julio7745/PETA/Programa de interface gráfica/Fotos base/2.png

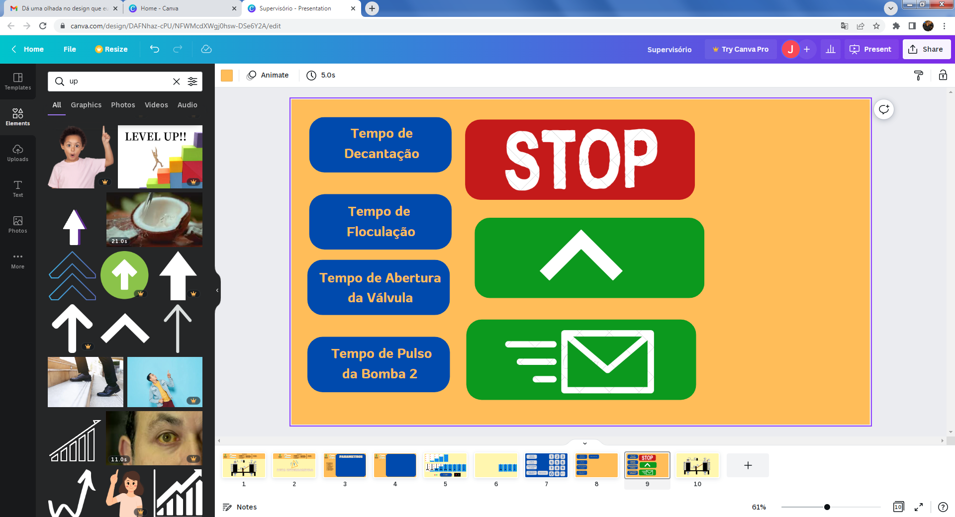
Programa de interface gráfica/Fotos base/2.png
