julio7745/PETA/Ferramentas Planejamento/Planilha Projeto Interdisciplinar (1).pdf

# Divisão de Funções

Componentes | Líderes responsáveis
Atuadores | Emanuelle Araújo
Sensores | Lorrana Aparecida
Controladores | Sthefane Gonçalves
Placas de circuitos | Júlio César

# LÍDER DE EQUIPE: Lucas Barbosa

Coordenador de montagem: | Coordenador de automação:
Marisa Camargos | Júlio César
Estrutura | Lucas Barbosa | Controlador | Marisa Camargos
| Emanuelle Araújo | | Sthefane Gonçalves
| Sthefane Gonçalves | Supervisor | Yasmin Mariane
Instrumentação | Lorrana Aparecida | | Emanuelle Araújo
| Marisa Camargos | | --
| Júlio César | Eletrônica | Lucas Barbosa
| Yasmin Mariane | | Júlio César
| -- | | Lorrana Aparecida

# Lista de materiais e previsão orçamentária

Tipo de material | Quantidade | Aquisição | Doação | Preço em reais

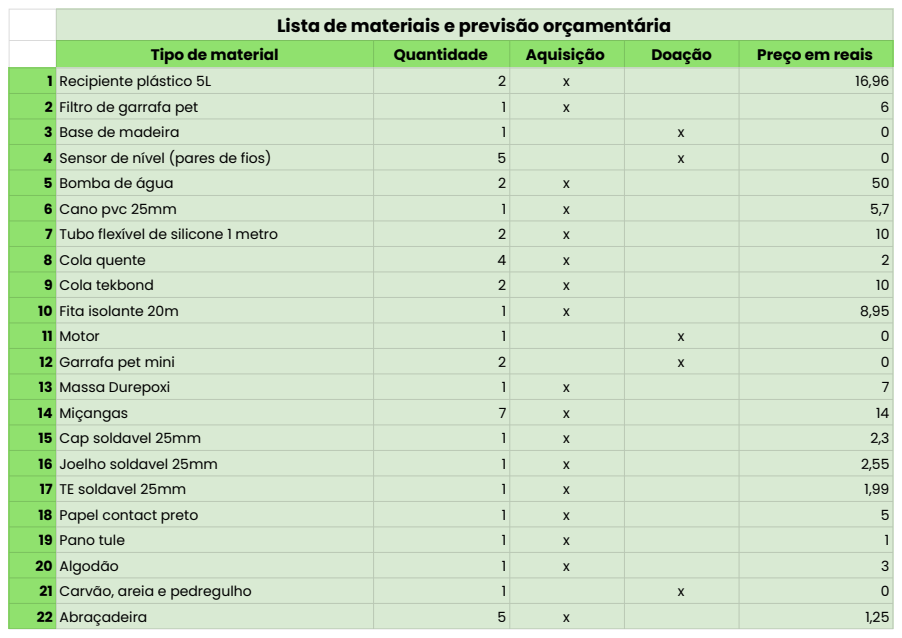
[picture p2: page 3]
Recipiente plástico 5L; Filtro de garrafa pet; Base de madeira; Sensor de nível (pares de fios); Bomba de água; Cano pvc 25mm; Tubo flexível de silicone 1 metro; Cola quente; Cola tekbond; Fita isolante 20m; Motor; Garrafa pet mini; Massa Durepoxi; Miçangas; Cap soldavel 25mm; Joelho soldavel 25mm; TE soldavel 25mm; Papel contact preto; Pano tule; Algodão; Carvão, areia e pedregulho; Abraçadeira

23 Servo motor | | 1 | | x | 0
24 Mixer | | 1 | | x | 0
25 Arame | | 1 | | x | 0
26 Cola silicone | | 1 | x | | 11
27 Placa de Circuito Impresso | | 1 | x | | 57,4
28 Cano pvc 50mm | | 1 | | x | 0
29 Componentes eletrônicos | | | x | | 51
30 Transporte do projeto | | 2 | x | | 20
31 Adesivo | | 1 | x | | 5,5
32 Componentes eletrônicos a parte | | | x | | 54,71
Total | 347,31

## CRONOGRAMA DE EXECUÇÃO DO PROJETO

TAREFAS

PRAZOS

MARÇO | ABRIL | MAIO | JUNHO | JULHO | AGOSTO | SETEMB | OUTUB

Definição do tema

Reunião com orientador
Confecção diagrama P&I

Estrutura no CAD

Fluxograma
Vídeo PITCH

Lista de materiais

Envio de documentos

Revisão e correção dos arquivos

Apresentação

Montagem da estrutura

Divisões do documento

Reunião entre os integrantes

Aquisição dos materiais
Materiais para parte elétrica Cronograma e atualizações

Correção de erros da estrutura

Desenvolvimento da parte elétrica

Testes
Aquisição da PCB

Tarefas realizadas
Tarefas a realizar

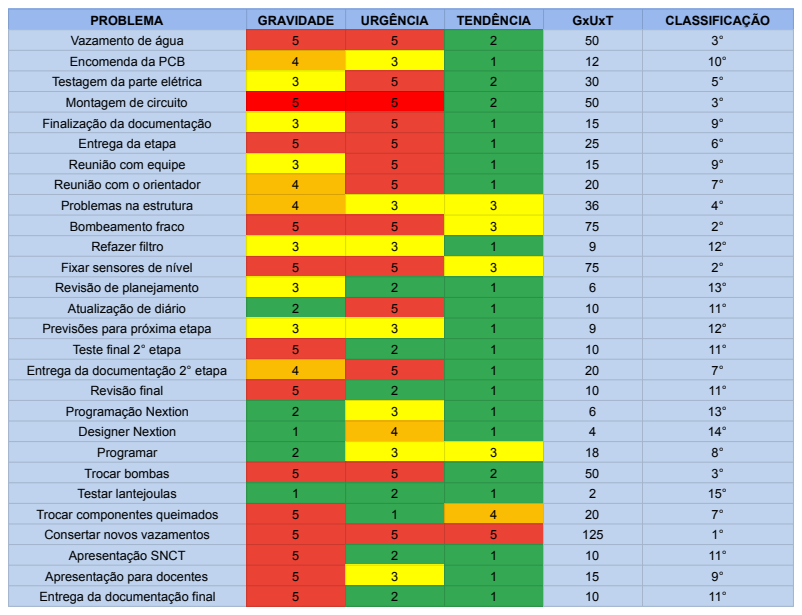
[picture p3: page 6]
PROBLEMA; GRAVIDADE; URGÊNCIA; TENDÊNCIA; GxUxT; CLASSIFICAÇÃO; Vazamento de água; Encomenda da PCB; Testagem da parte elétrica; Montagem de circuito; Finalização da documentação; Entrega da etapa; Reunião com equipe; Reunião com o orientador; Problemas na estrutura; Bombeamento fraco; Refazer filtro; Fixar sensores de nível; Revisão de planejamento; Atualização de diário; Previsões para próxima etapa; Teste final 2° etapa; Entrega da documentação 2° etapa; Revisão final; Programação Nextion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

## CHECK LIST

ATIVIDADES | NÃO | PARCIALMENTE | SIM
Reunião com o orientador . | | | X
Definição das fases do Projeto. | | | X
Reunião para dar início a 1º documentação do projeto | | | X
Divisão de tarefas para a primeira entrega. | | | X
Execução das tarefas relacionadas a 1º entrega | | | X
Envio do documento para o orientador fazer a correção | | | X
Montagem do documento para a entrega da 1ºEtapa | | | X
Entrega do 1º documento no AVA | | | X
Correção do documento eviado na 1º Etapa | | | X
Compra de matériais | X
Início ao processo de construção do protótipo | | | X
Apresentação da estrutura do projeto | | | X
Teste de verificação da estrutura | | | X
Adaptações no protótipo | | | X
Início a montagem do circuito | | | X
Reunião para dar início a 2º documentação do projeto | | | X
Divisão de tarefas para a segunda entrega. | | | X
Execução das tarefas relacionadas a segunda entrega. | | | X
Montagem do documento para a entrega da 2ºEtapa | | | X
Entrega do 2º documento no AVA | | | X
Correção do documento enviado na 2º Etapa | | | X
Execução de tarefas relacionadas a terceira entrega | | | X
Revisão dos documentos e outros | | | X
Checagem final do protótipo | | | X
Divisão das funções para a apresentação | | | X
Apresentação final na SNCT | | | X
Entrega final dos documentos no AVA | | | X
