julio7745/PETA/P_I/Diagrama P_I PETA.pdf

A | B | C | D | E | LEGENDA

A

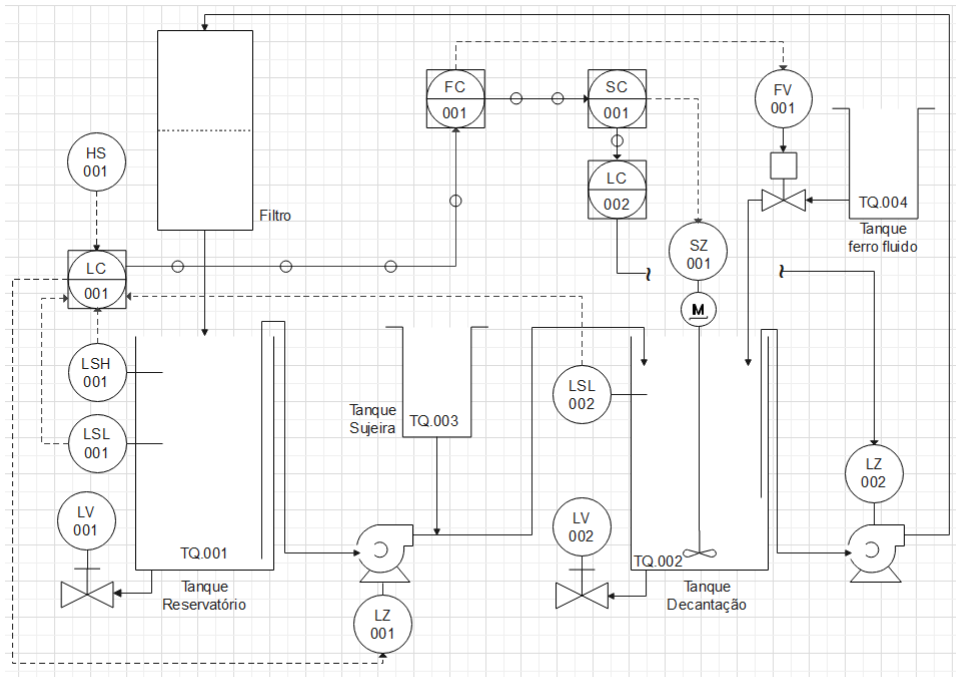
[picture p4: figure]

B

C

D

E

REV | DATA | DES | REV | AP
01 | 25.04.2022 | JCQC | LBO | LBO
02 | 16.06.2022 | JCQC | LBO | LBO
03 | 26.06.2022 | JCQC | MCB | LBO

## Protótipo de Estação de Tratamento de Água

Diagrama P&I PETA
