julio7745/PETA/Programa de interface gráfica/Fotos base/3.png

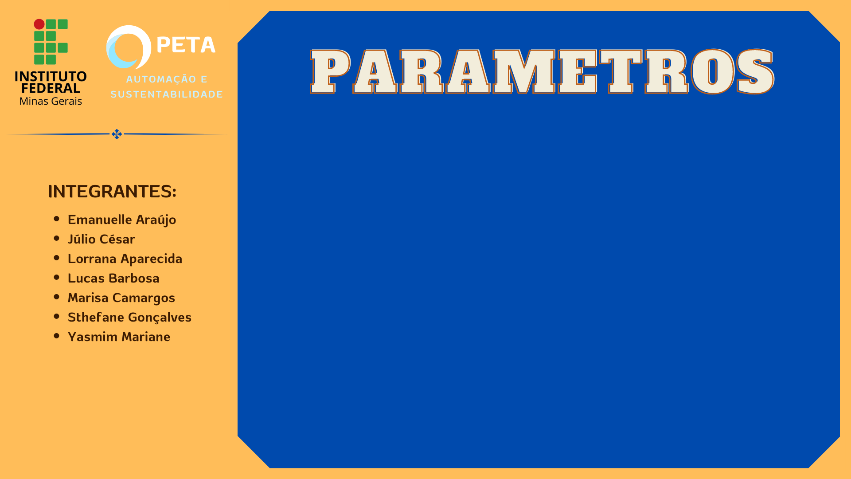
Programa de interface gráfica/Fotos base/3.png
