julio7745/PETA/Programa de interface gráfica/Fotos base/4.png

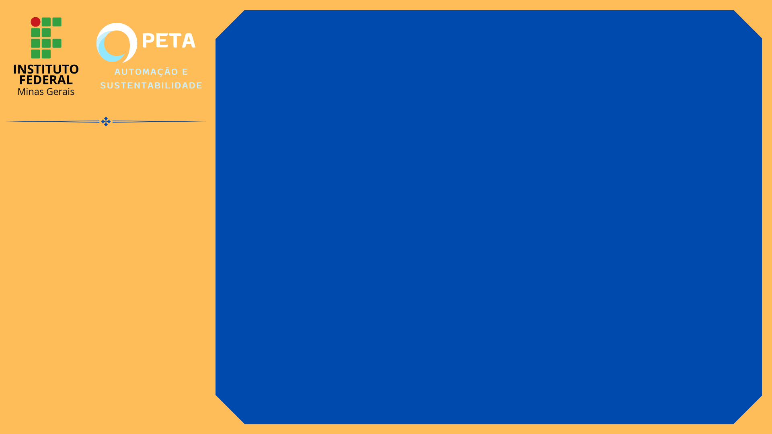
Programa de interface gráfica/Fotos base/4.png
