julio7745/PETA/Programa de interface gráfica/Fotos base/5.png

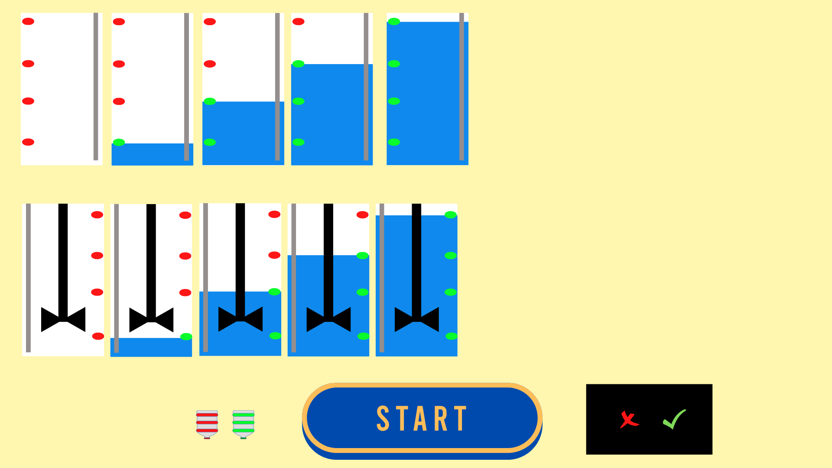
Programa de interface gráfica/Fotos base/5.png
