julio7745/PETA/Programa de interface gráfica/Fotos base/6.png

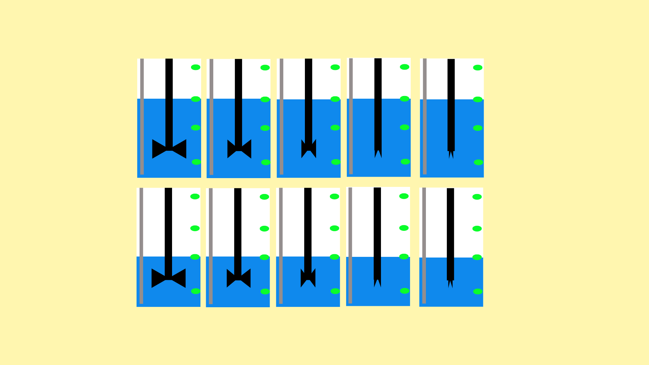
Programa de interface gráfica/Fotos base/6.png
