julio7745/PETA/Programa de interface gráfica/Fotos base/7.png

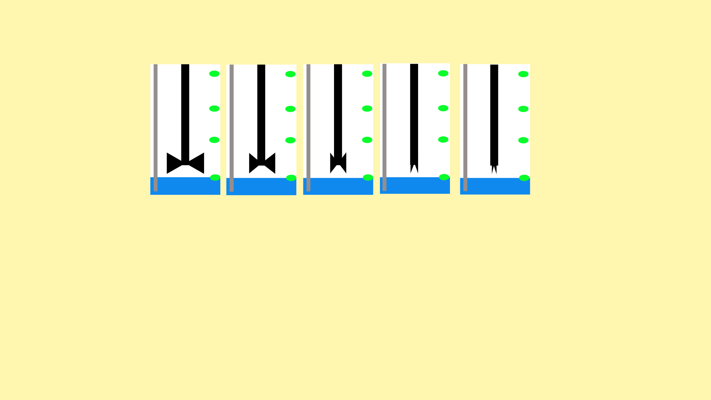
Programa de interface gráfica/Fotos base/7.png
