julio7745/PETA/Programa de interface gráfica/Fotos base/9.png

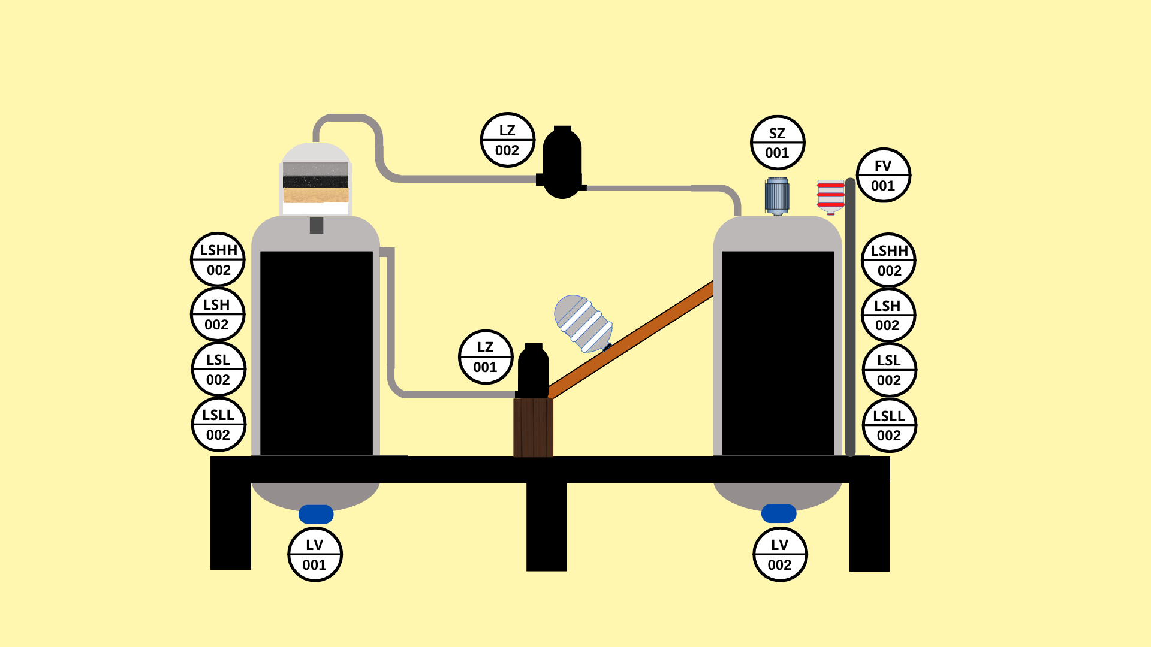
Programa de interface gráfica/Fotos base/9.png
