julio7745/PETA/Programa de interface gráfica/Fotos base/10.png

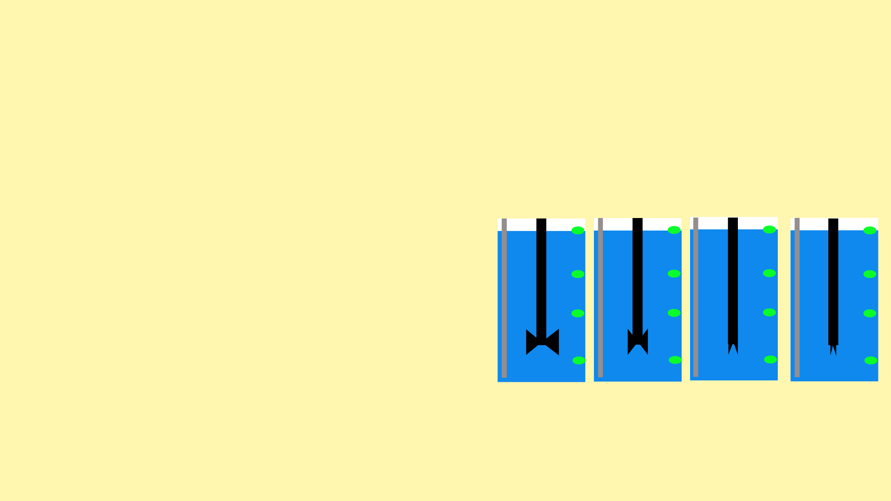
Programa de interface gráfica/Fotos base/10.png
