julio7745/PETA/Programa de interface gráfica/Fotos base/11.png

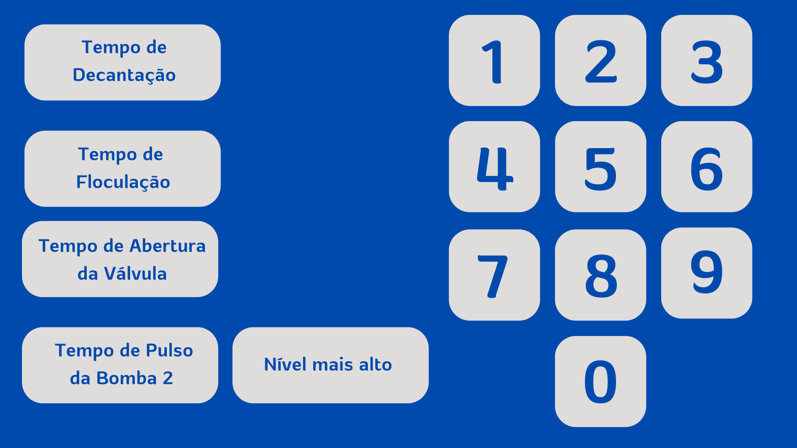
Programa de interface gráfica/Fotos base/11.png
