julio7745/PETA/Programa de interface gráfica/Fotos base/12.png

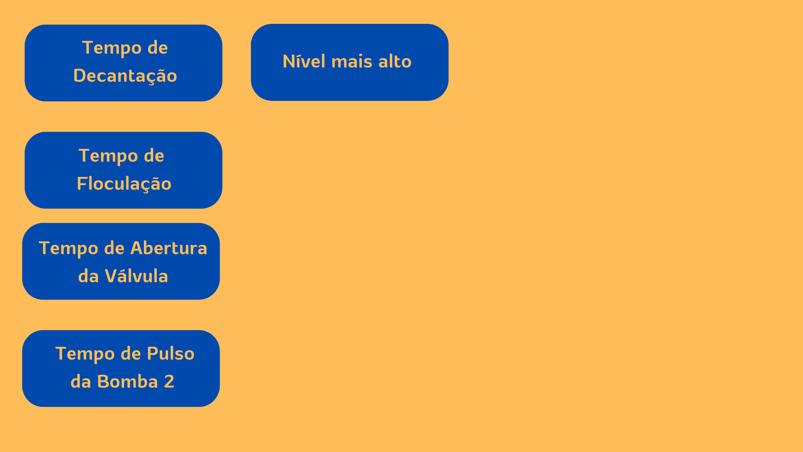
Programa de interface gráfica/Fotos base/12.png
