julio7745/PETA/Programa de interface gráfica/Fotos base/13.png

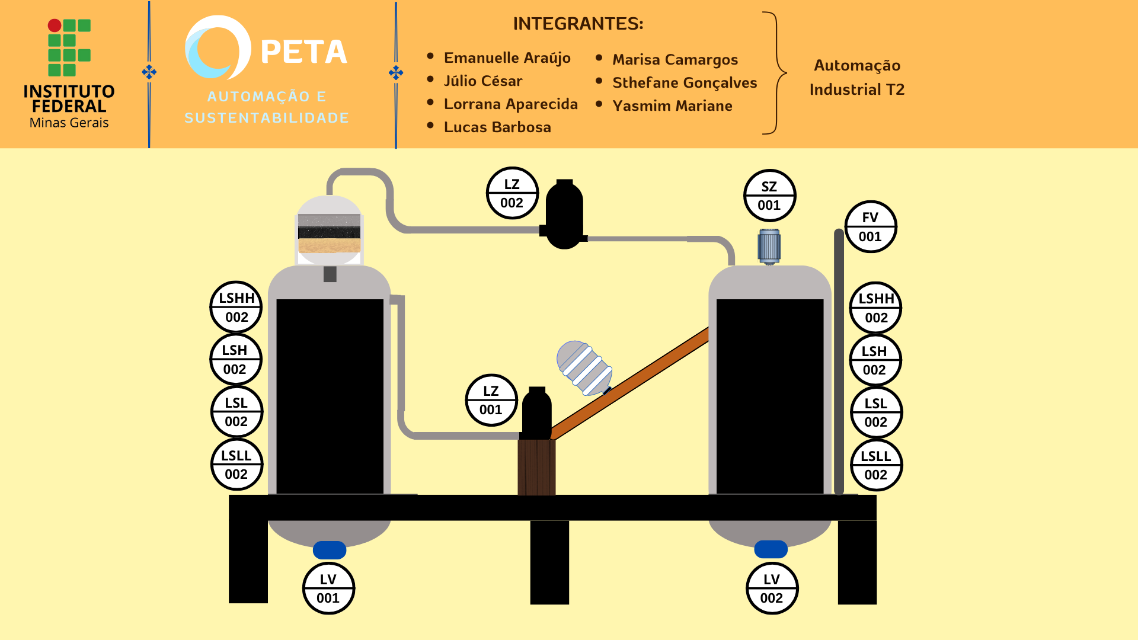
Programa de interface gráfica/Fotos base/13.png
