julio7745/PETA/Programa de interface gráfica/Fotos base/14.png

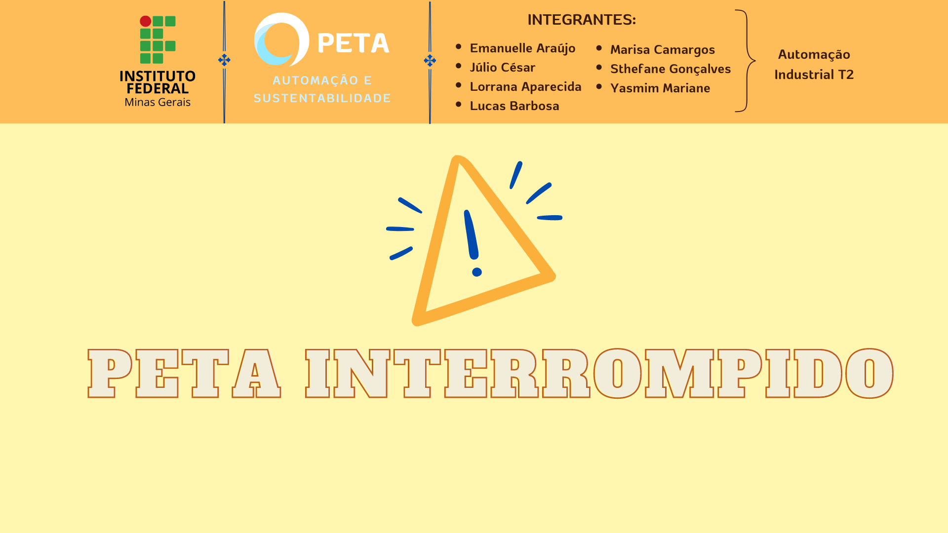
Programa de interface gráfica/Fotos base/14.png
