julio7745/PETA/Programa de interface gráfica/Fotos base/15.png

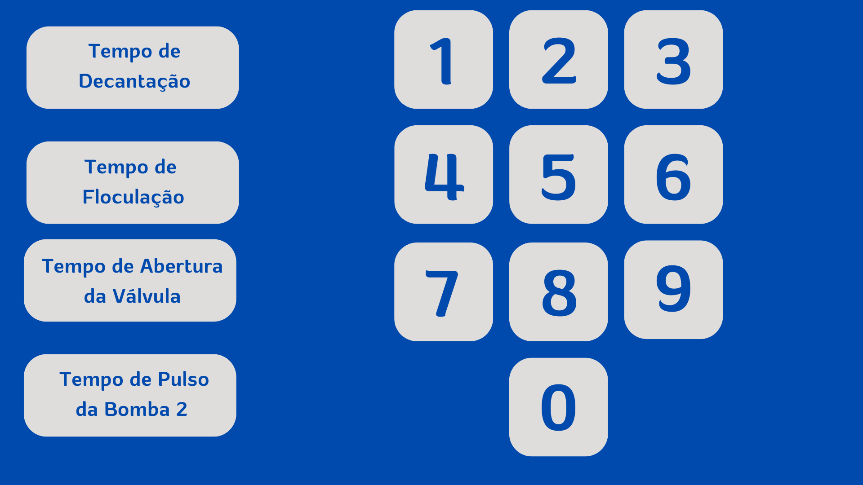
Programa de interface gráfica/Fotos base/15.png
