julio7745/PETA/Programa de interface gráfica/Fotos base/16.png

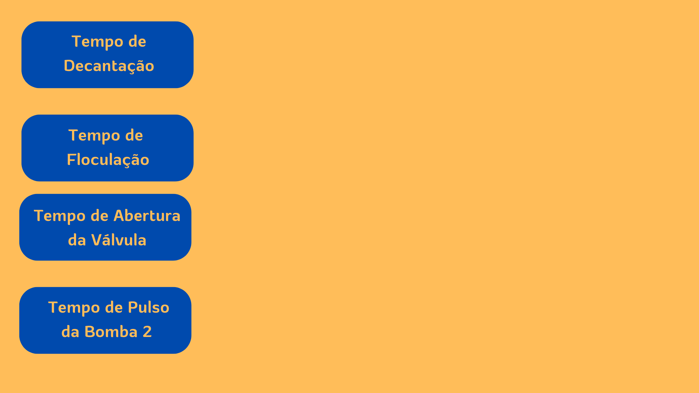
Programa de interface gráfica/Fotos base/16.png
