julio7745/PETA/Programa de interface gráfica/Fotos base/18.png

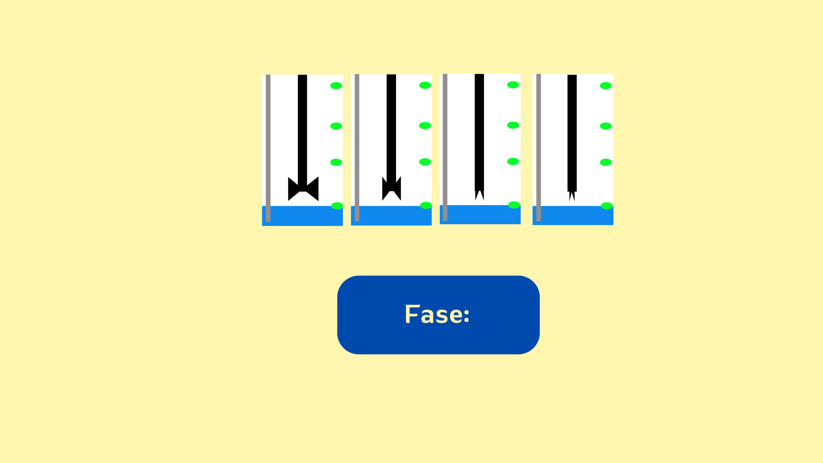
Programa de interface gráfica/Fotos base/18.png
