julio7745/PETA/Desenvolvimento PCB/PCB PETA prints.pdf

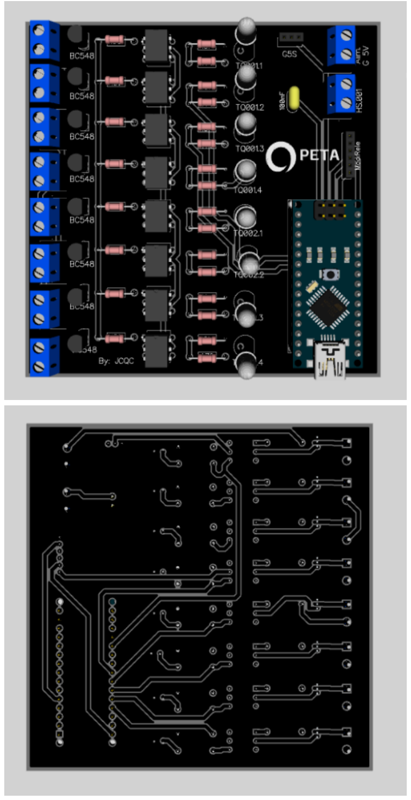
[picture p35: page 1]
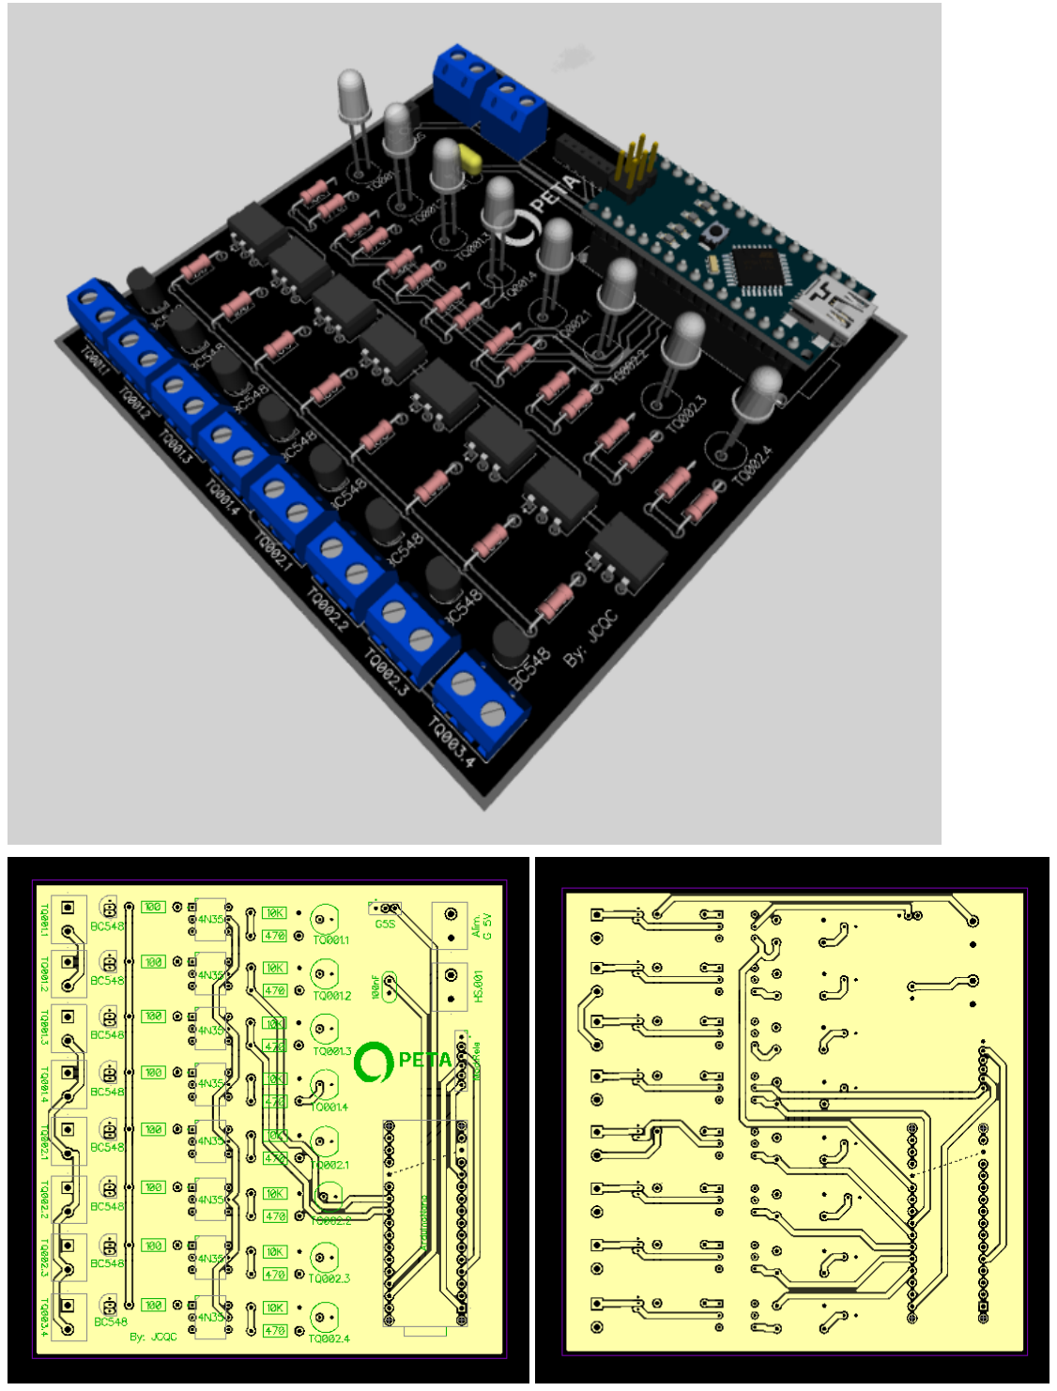
[picture p36: page 2]
