julio7745/PETA/Desenvolvimento PCB/PCB PETA orcamento.pdf

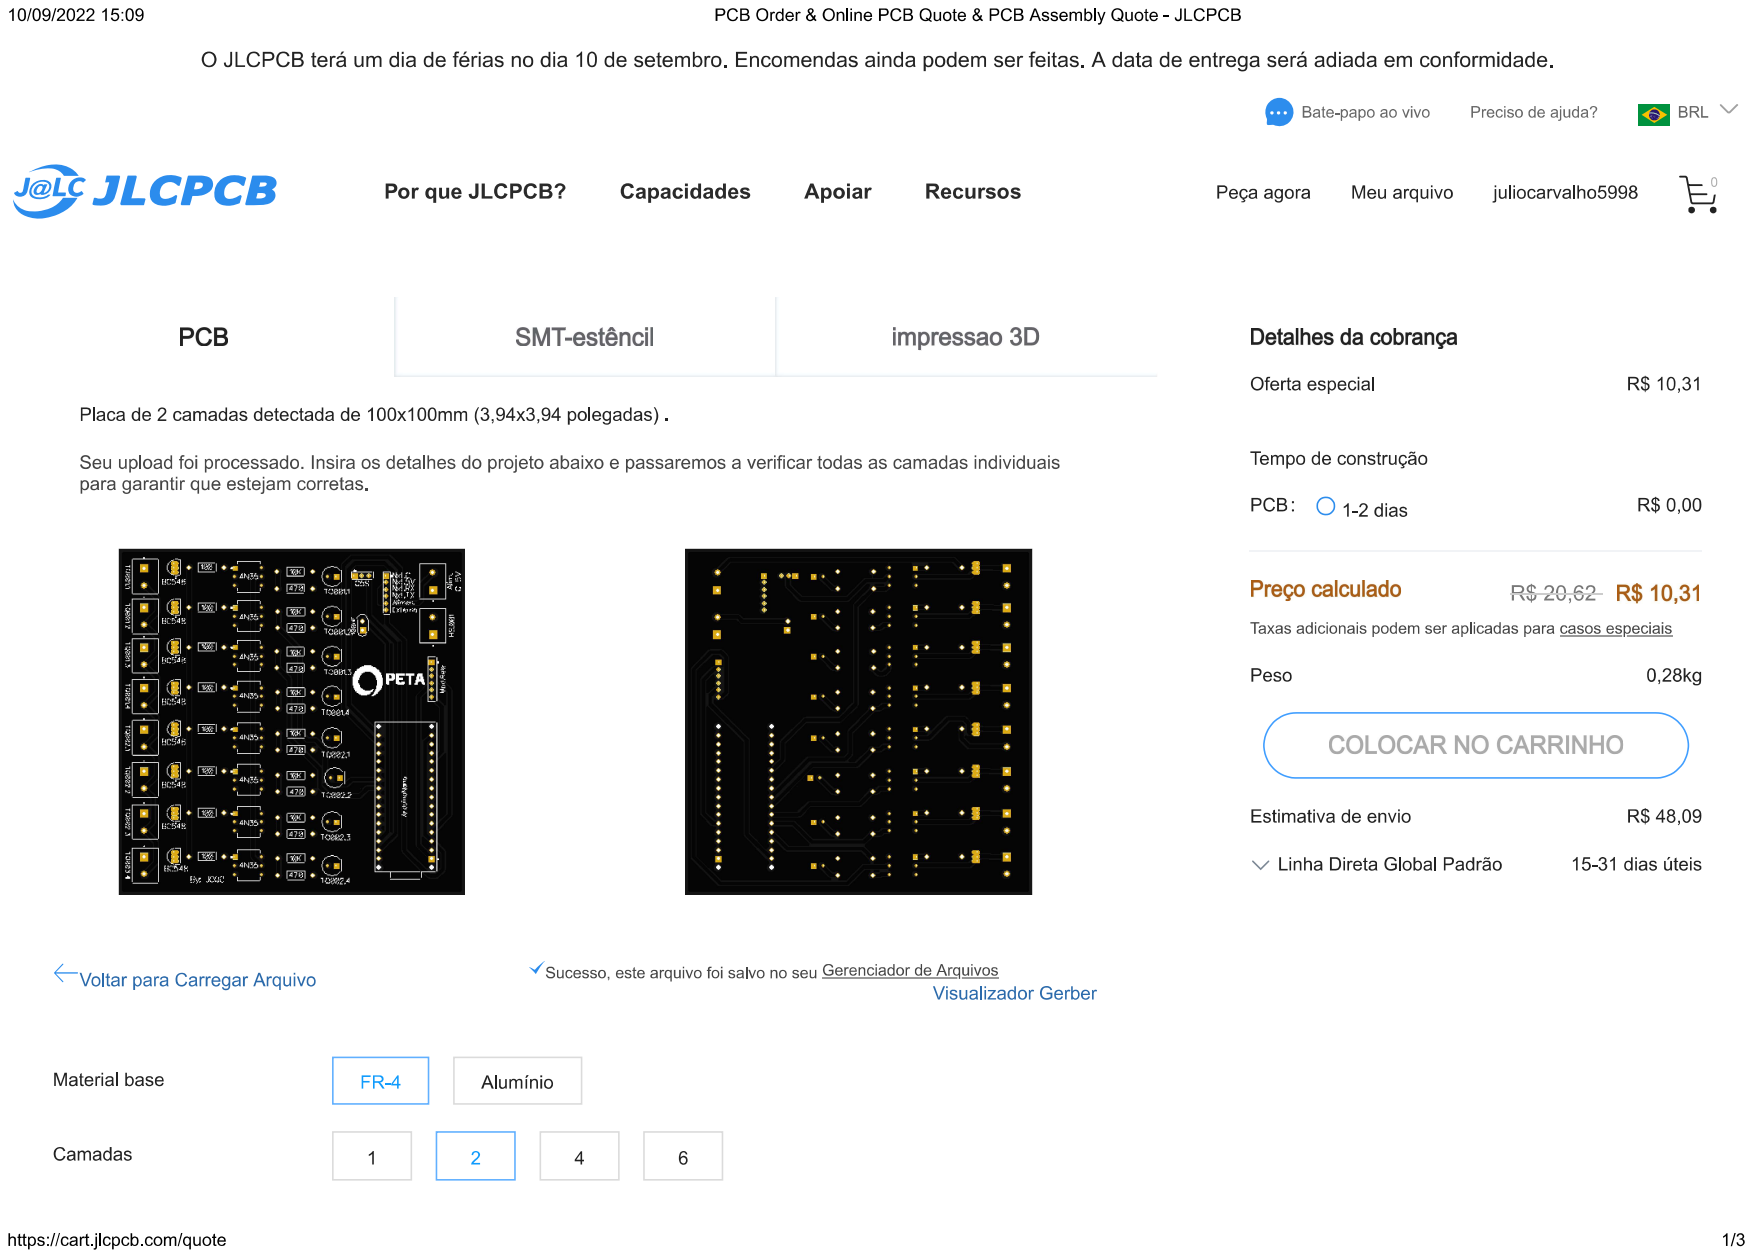
[picture p37: page 1]

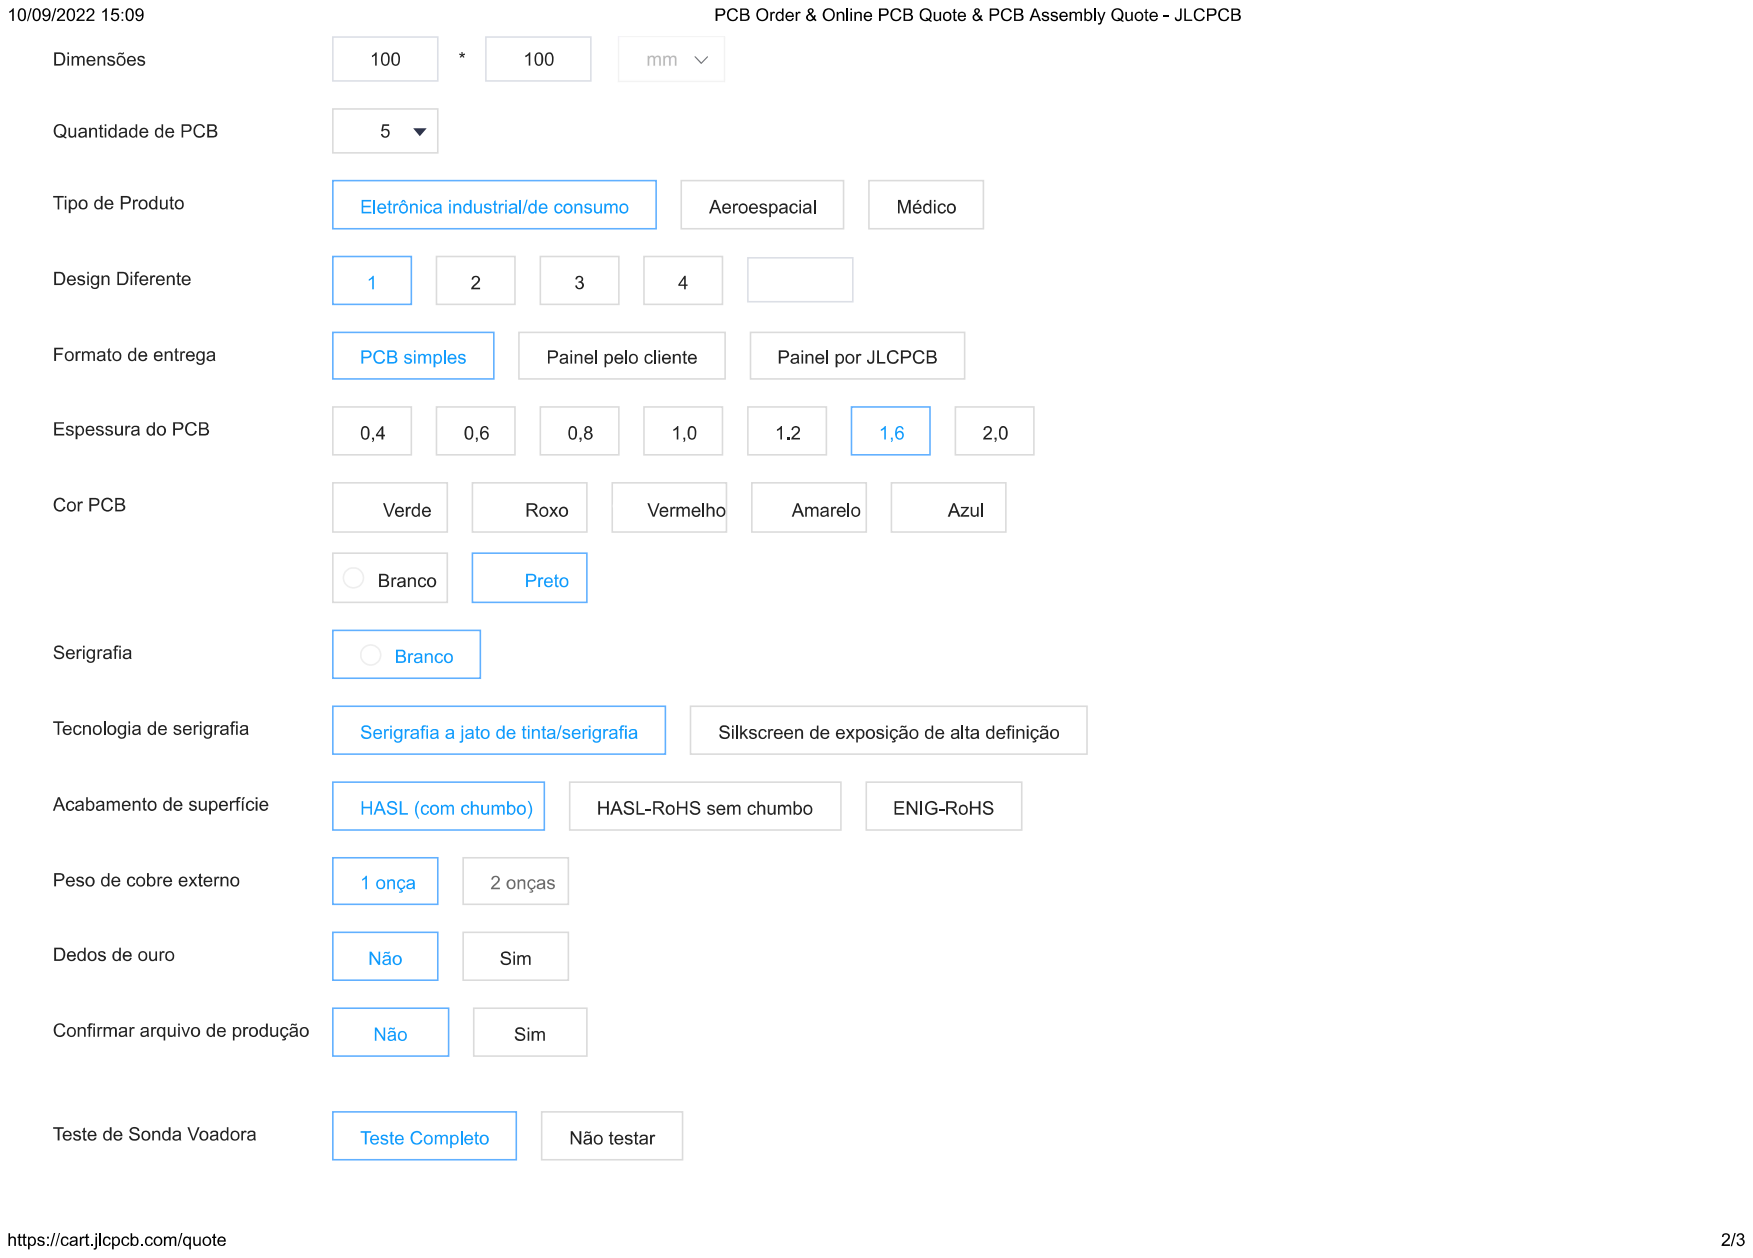
[picture p38: page 2]

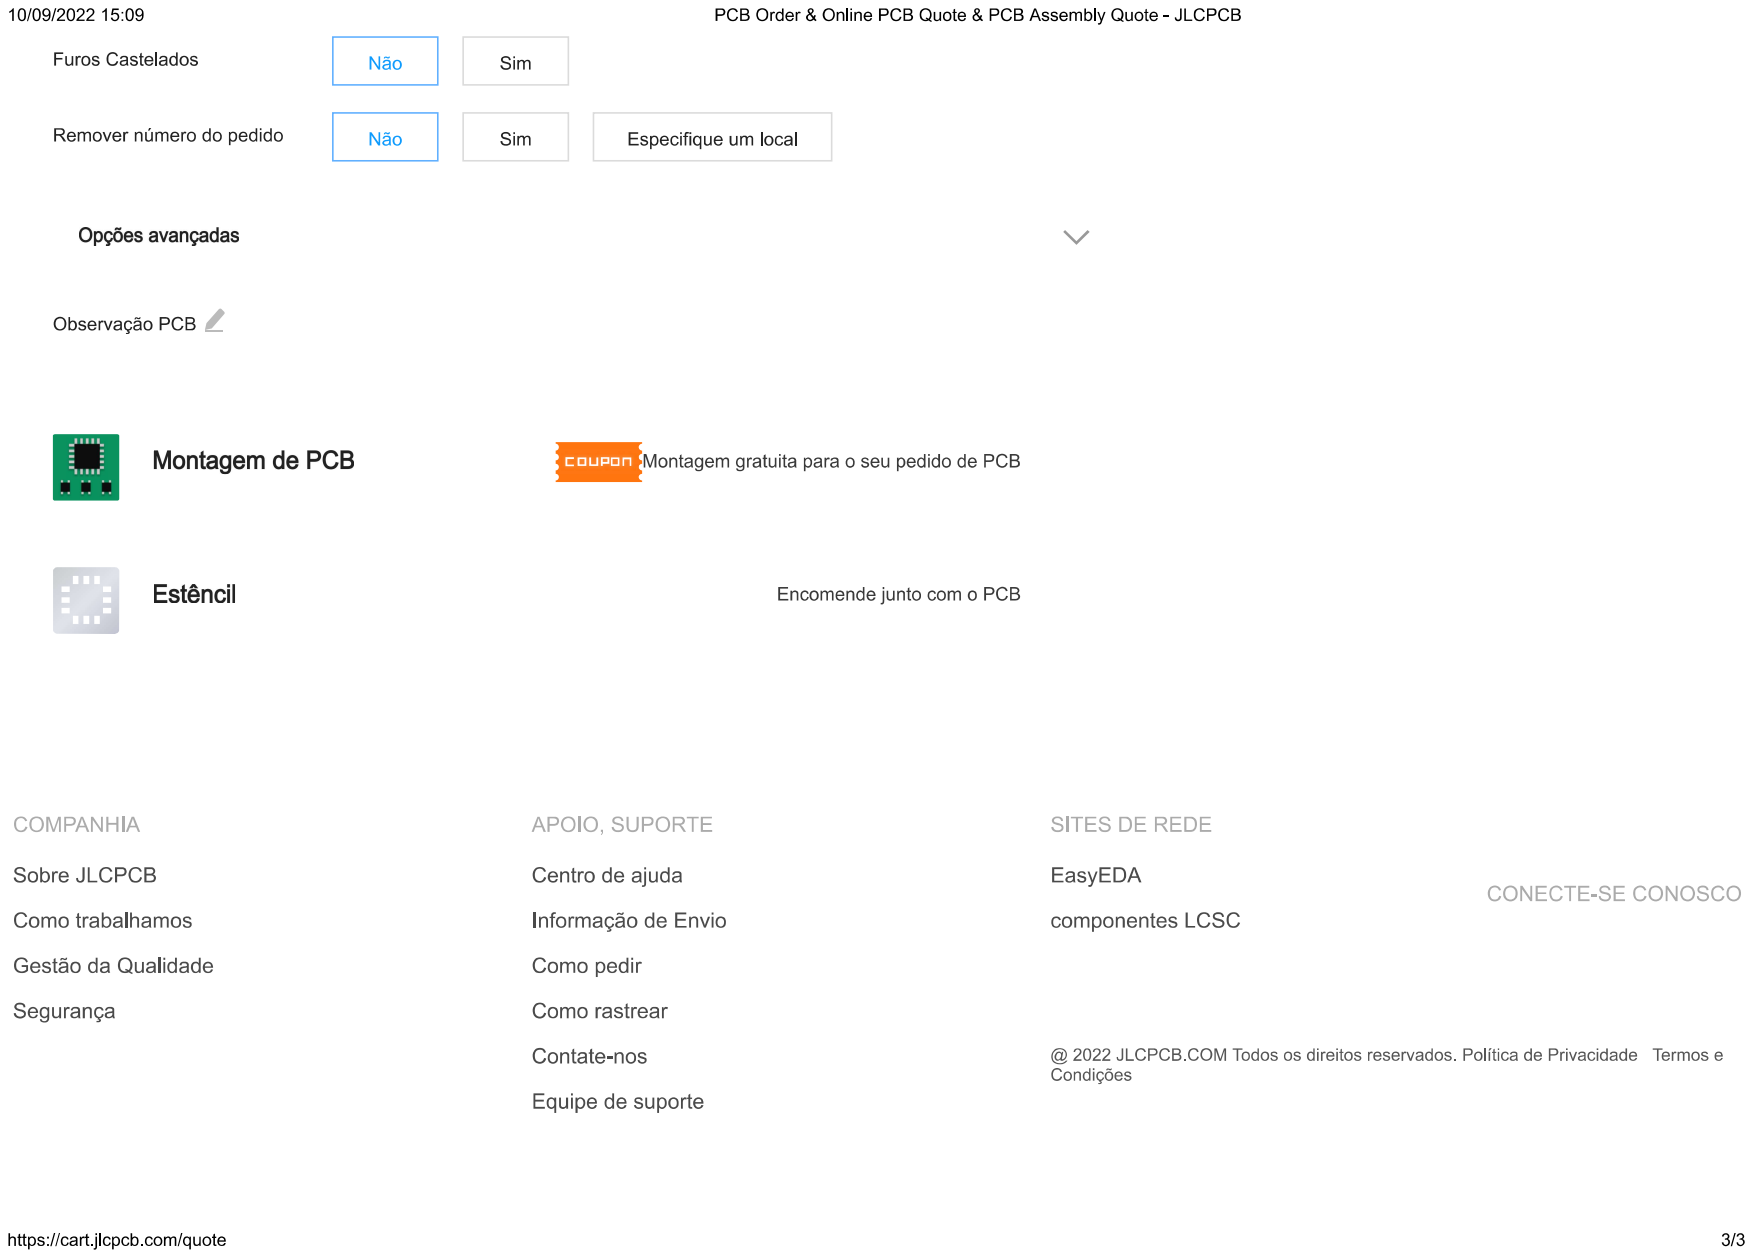
[picture p39: page 3]
