julio7745/PETA/(list of files, drawings)

Other design files:
Desenvolvimento PCB/PCB-PETA.dip
Desenvolvimento PCB/PETA.dch
Simulação Eletrica/PETA.pdsprj
